iamhabban-blip/airnode-s3/images/airnode-kicad-erc-clean.png

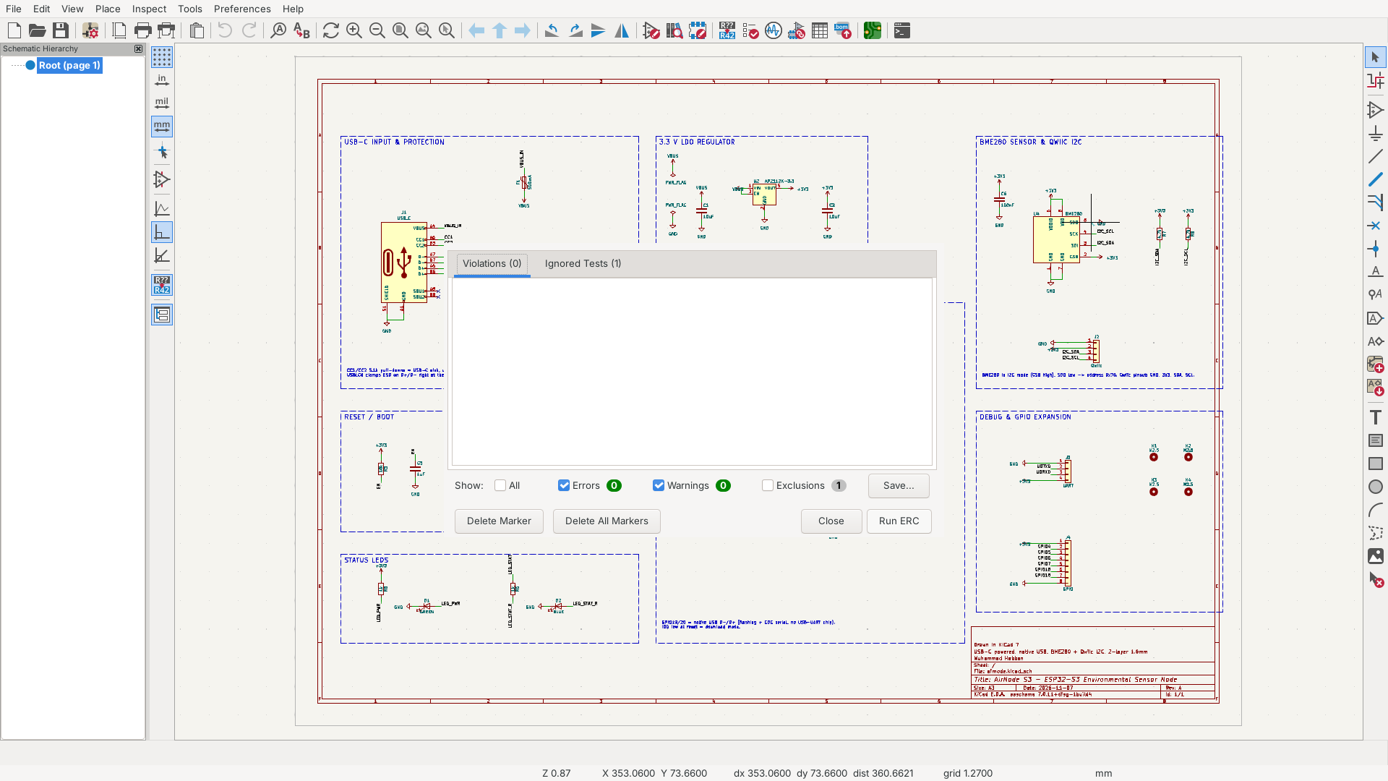
images/airnode-kicad-erc-clean.png
