iamhabban-blip/airnode-s3/images/airnode-kicad-schematic-editor.png

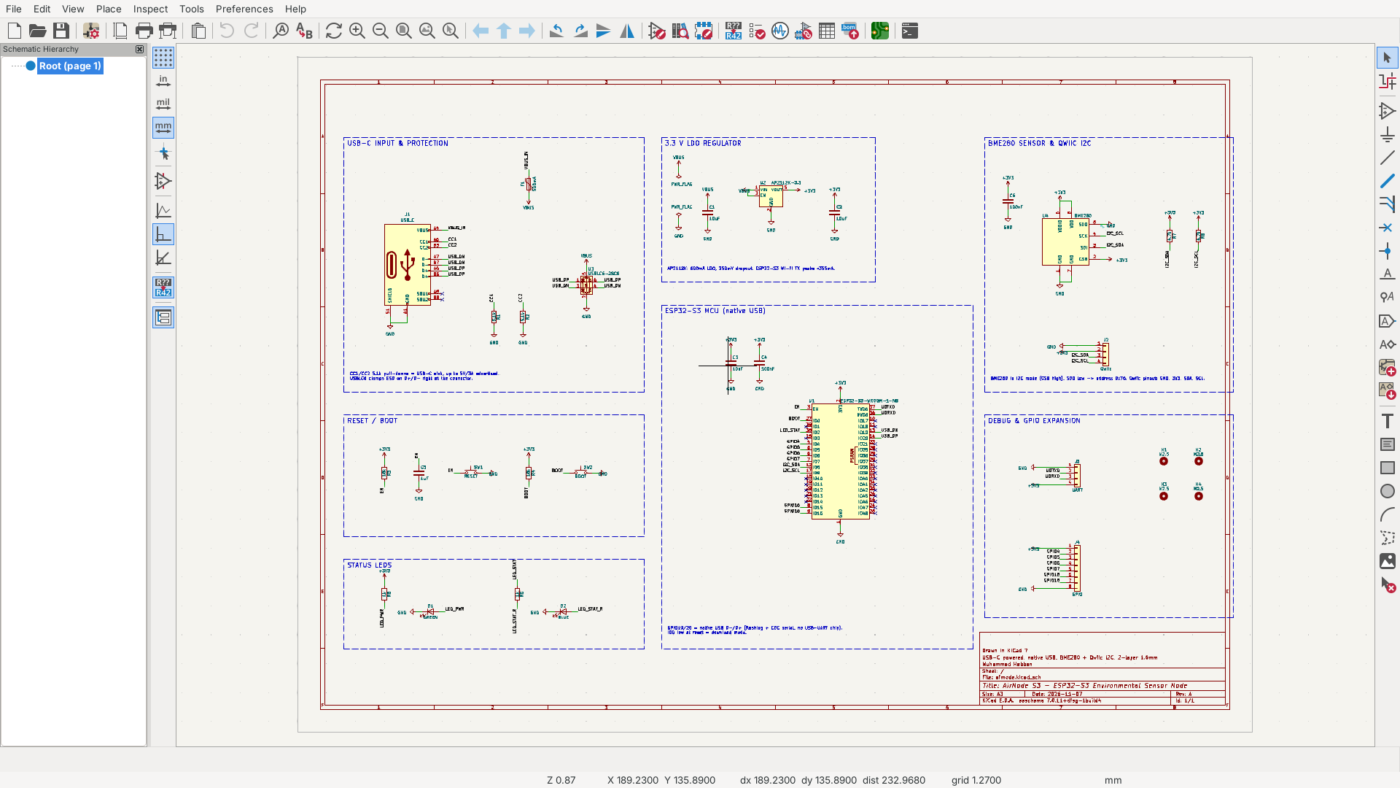
images/airnode-kicad-schematic-editor.png
