iamhabban-blip/airnode-s3/fab/airnode-bom.csv

Comment | Designator | Footprint | Manufacturer Part | Quantity | LCSC Part #
USB_C | J1 | USB_C_Receptacle_GCT_USB4105-xx-A_16P_TopMnt_Horizontal | GCT USB4105-GF-A | 1
5.1k | R1,R2 | R_0603_1608Metric |  | 2
500mA | F1 | Fuse_1206_3216Metric | Littelfuse 1206L050YR | 1
USBLC6-2SC6 | U3 | SOT-23-6 | ST USBLC6-2SC6 | 1
AP2112K-3.3 | U2 | SOT-23-5 | Diodes AP2112K-3.3TRG1 | 1
10uF | C1,C2,C3 | C_0805_2012Metric |  | 3
ESP32-S3-WROOM-1-N8 | U1 | ESP32-S3-WROOM-1 | Espressif ESP32-S3-WROOM-1-N8 | 1
100nF | C4,C6 | C_0603_1608Metric |  | 2
10k | R3,R4 | R_0603_1608Metric |  | 2
1uF | C5 | C_0603_1608Metric |  | 1
RESET | SW1 | SW_SPST_TL3342 | E-Switch TL3342F160QG | 1
BOOT | SW2 | SW_SPST_TL3342 | E-Switch TL3342F160QG | 1
1k | R5,R6 | R_0603_1608Metric |  | 2
GREEN | D1 | LED_0603_1608Metric |  | 1
BLUE | D2 | LED_0603_1608Metric |  | 1
BME280 | U4 | Bosch_LGA-8_2.5x2.5mm_P0.65mm_ClockwisePinNumbering | Bosch BME280 | 1
4.7k | R7,R8 | R_0603_1608Metric |  | 2
Qwiic | J2 | JST_SH_SM04B-SRSS-TB_1x04-1MP_P1.00mm_Horizontal | JST SM04B-SRSS-TB | 1
UART | J3 | PinHeader_1x04_P2.54mm_Vertical |  | 1
GPIO | J4 | PinHeader_1x08_P2.54mm_Vertical |  | 1
