iamhabban-blip/airnode-s3/fab/airnode.step

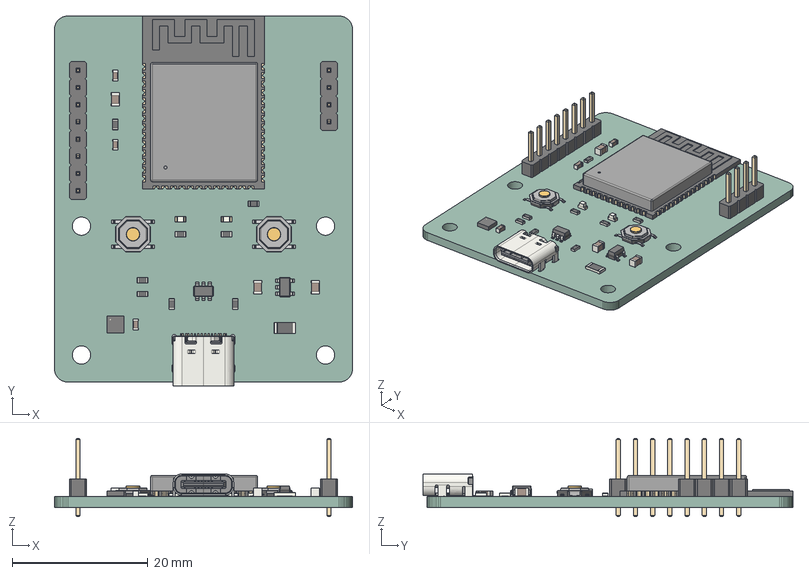
[picture p10: CAD file, 2026-11-07]
fab/airnode.step
44.0 x 54.6 x 11.5 mm
R_0603_1608Metric x 8
C_0805_2012Metric x 3
Fuse_1206_3216Metric
PinHeader_1x04_P254mm_Vertical
SW_SPST_TL3342 x 2
LED_0603_1608Metric x 2
USB_C_Receptacle_16P_TopMnt_Horizontal_GCT_USB4105-xx-A
SOT_23_6
PinHeader_1x08_P254mm_Vertical
C_0603_1608Metric x 3
Bosch_LGA_8_25x25mm_P065mm_ClockwisePinNumbering
SOT_23_5
ESP32-S3-WROOM-1
airnode PCB
