iamhabban-blip/airnode-s3/docs/airnode-assembly-top.pdf

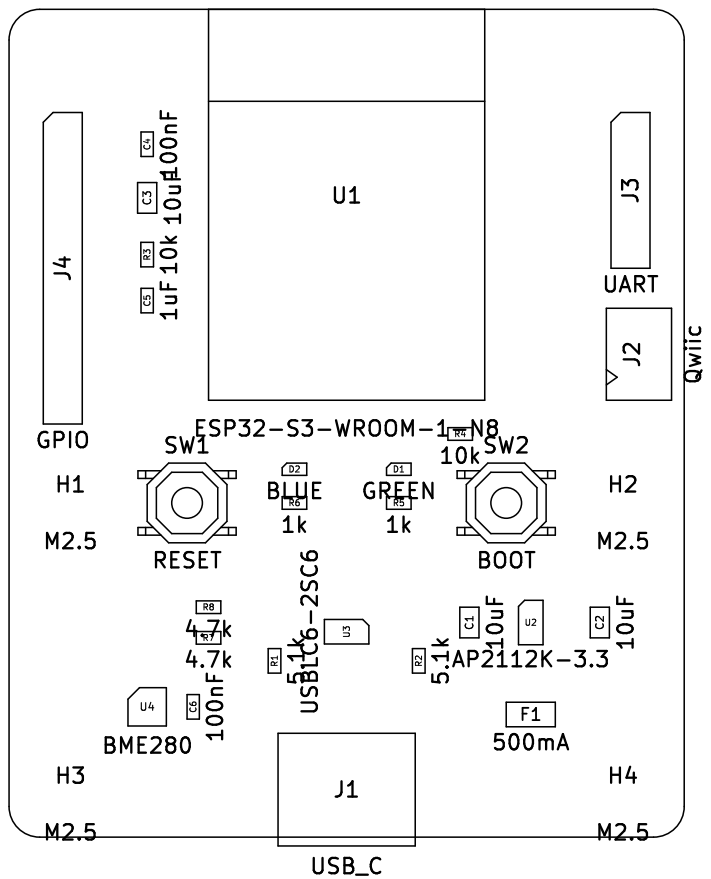
[picture p11: page 1]
