iamhabban-blip/airnode-s3/docs/airnode-schematic.pdf

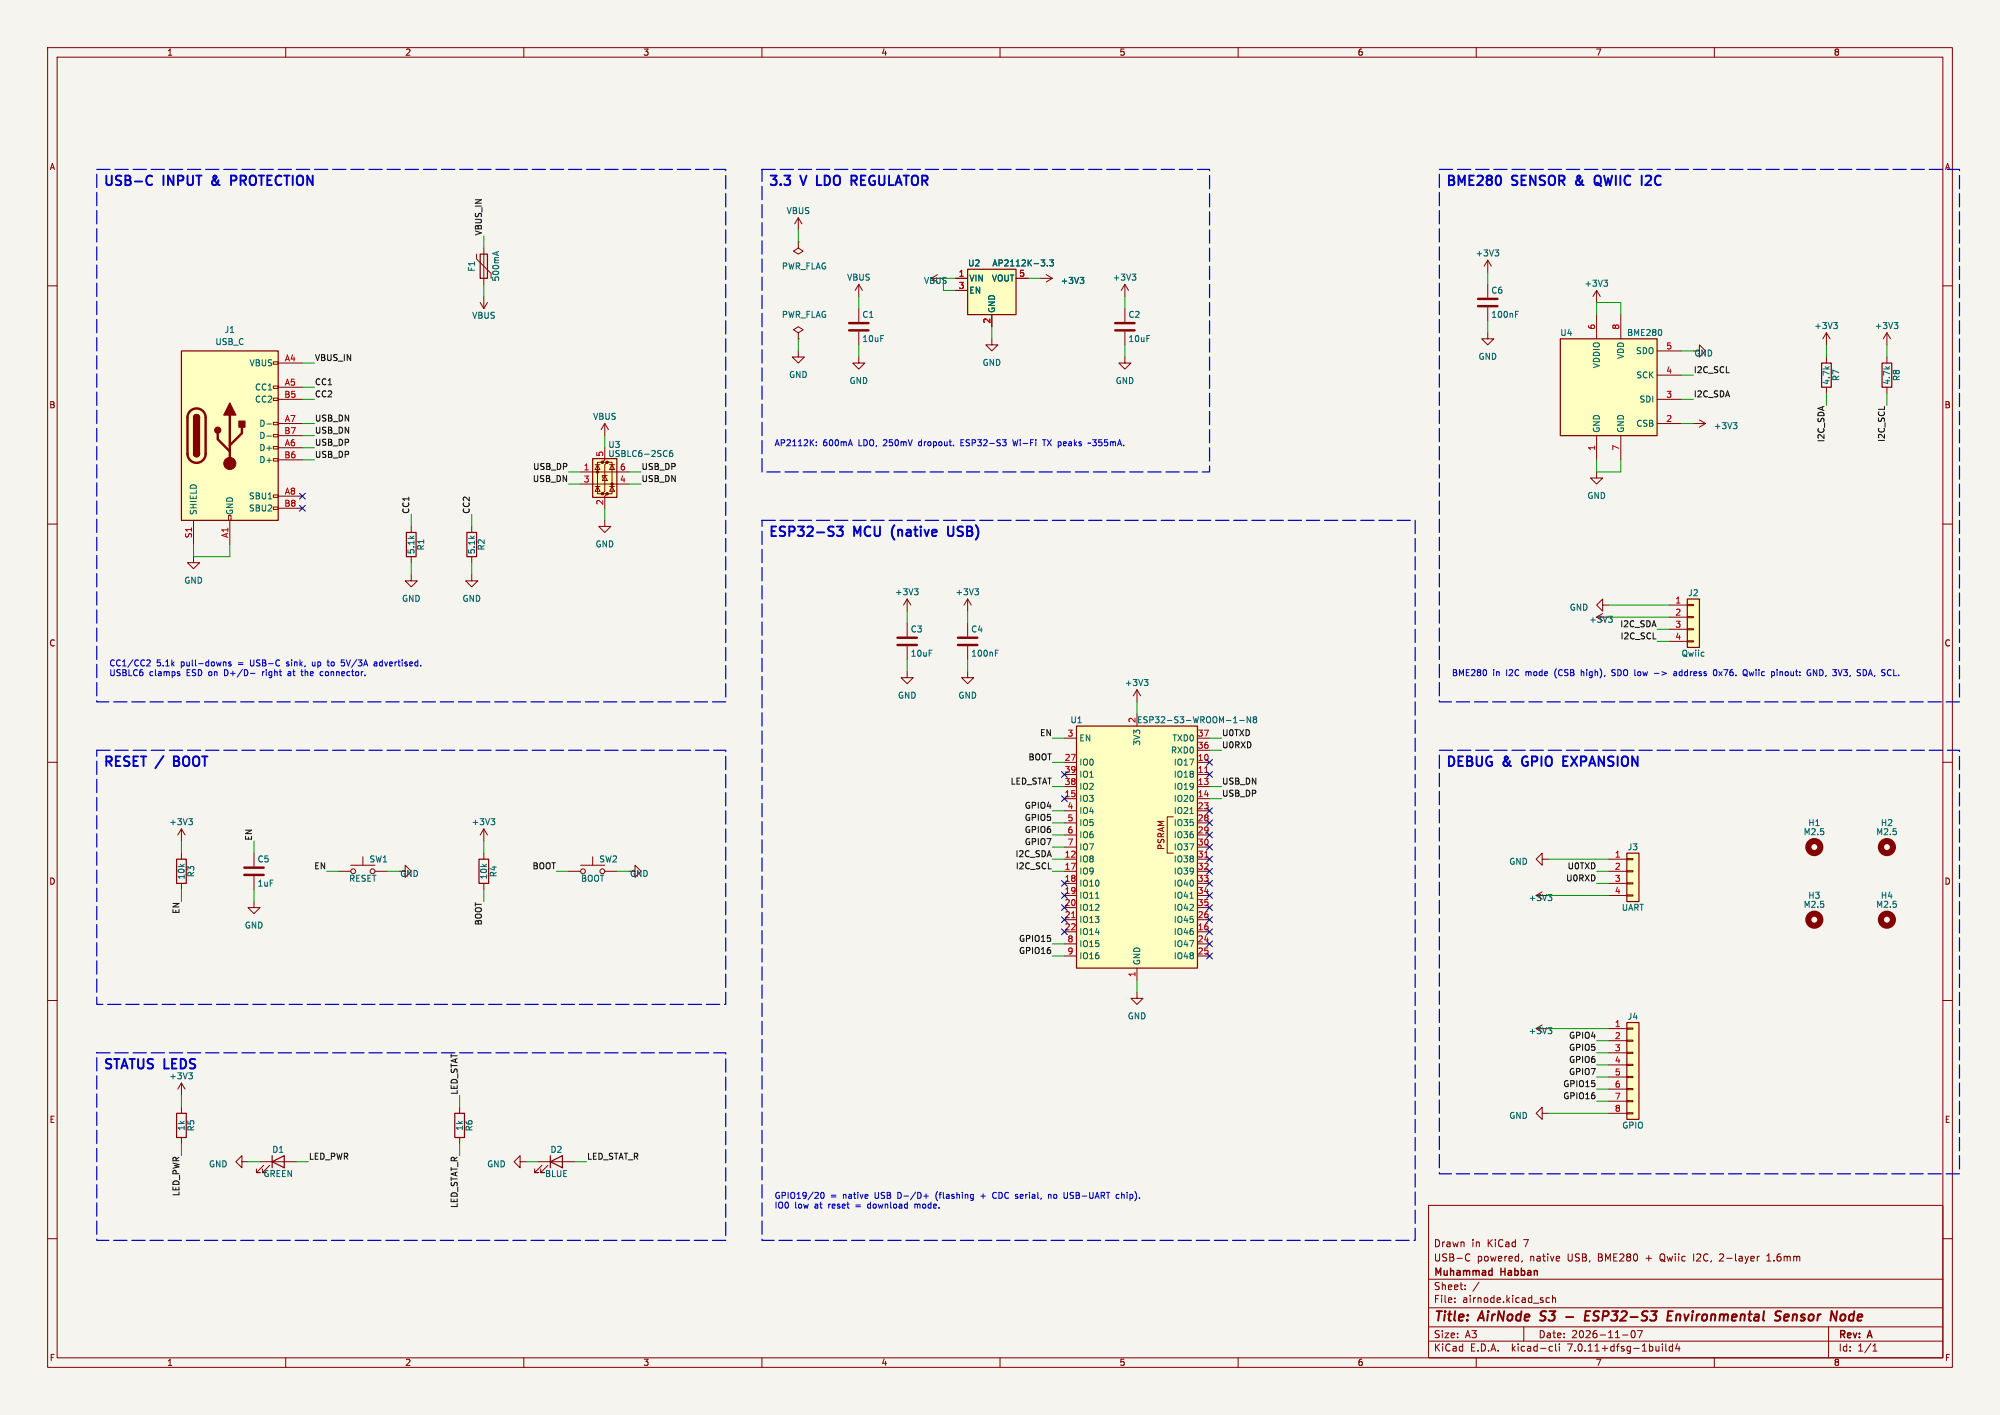
[picture p12: page 1]

1 CSB 2 SDI 3 SCK 4 SDO 5 VDDIO
