iamhabban-blip/airnode-s3/docs/airnode-layout.pdf

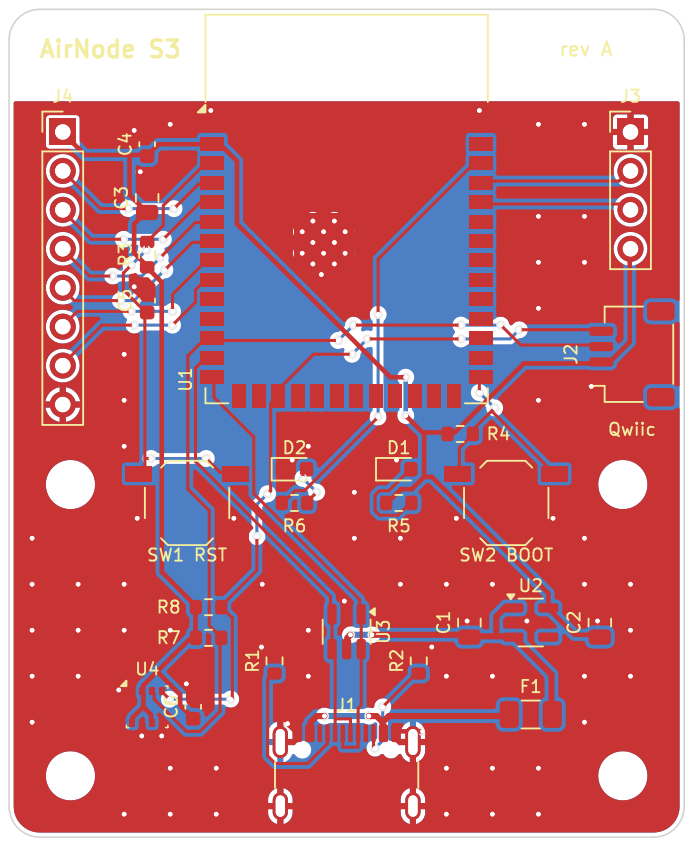
[picture p13: page 1]
