iamhabban-blip/airnode-s3/airnode.kicad_pcb

## KiCad design airnode.kicad_pcb (2026-11-07)

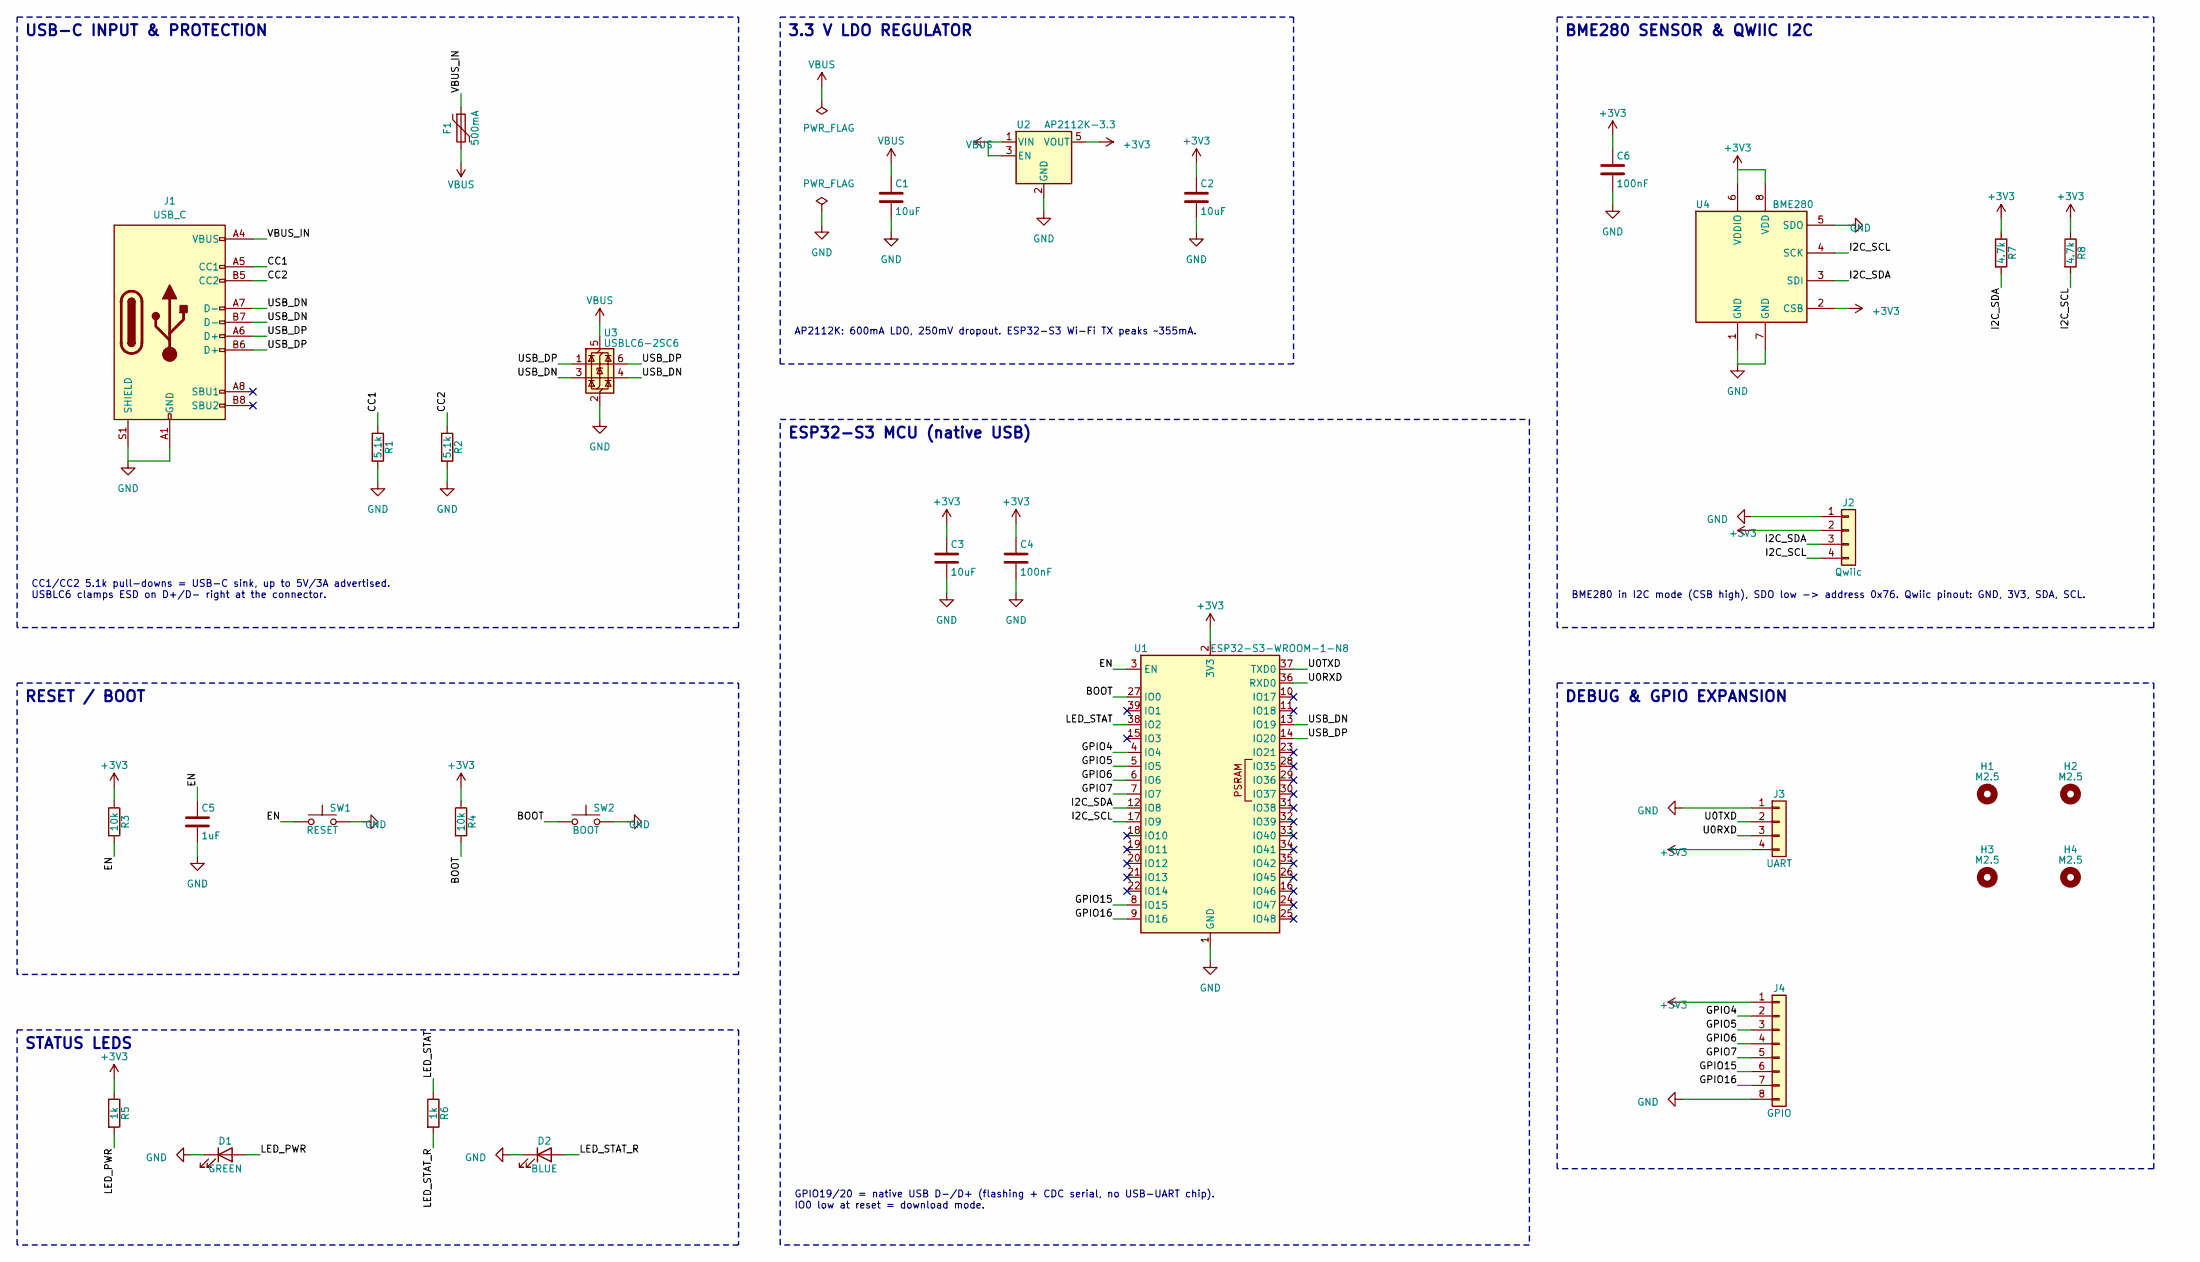
[picture p14: schematic airnode.kicad_sch, AirNode S3 - ESP32-S3 Environmental Sensor Node]

Parts:
C1, C2, C3: 10uF; C_0805_2012Metric
C4, C6: 100nF; C_0603_1608Metric
C5: 1uF; C_0603_1608Metric
D1: GREEN; LED_0603_1608Metric
D2: BLUE; LED_0603_1608Metric
F1: 500mA; Fuse_1206_3216Metric; MPN Littelfuse 1206L050YR
H1, H2, H3, H4: M2.5; MountingHole_2.7mm_M2.5
J1: USB_C; USB_C_Receptacle_GCT_USB4105-xx-A_16P_TopMnt_Horizontal; MPN GCT USB4105-GF-A
J2: Qwiic; JST_SH_SM04B-SRSS-TB_1x04-1MP_P1.00mm_Horizontal; MPN JST SM04B-SRSS-TB
J3: UART; PinHeader_1x04_P2.54mm_Vertical
J4: GPIO; PinHeader_1x08_P2.54mm_Vertical
R1, R2: 5.1k; R_0603_1608Metric
R3, R4: 10k; R_0603_1608Metric
R5, R6: 1k; R_0603_1608Metric
R7, R8: 4.7k; R_0603_1608Metric
SW1: RESET; SW_SPST_TL3342; MPN E-Switch TL3342F160QG
SW2: BOOT; SW_SPST_TL3342; MPN E-Switch TL3342F160QG
U1: ESP32-S3-WROOM-1-N8; ESP32-S3-WROOM-1; MPN Espressif ESP32-S3-WROOM-1-N8
U2: AP2112K-3.3; SOT-23-5; MPN Diodes AP2112K-3.3TRG1
U3: USBLC6-2SC6; SOT-23-6; MPN ST USBLC6-2SC6
U4: BME280; Bosch_LGA-8_2.5x2.5mm_P0.65mm_ClockwisePinNumbering; MPN Bosch BME280

Connections:
+3V3: C2.1, C3.1, C4.1, C6.1, J2.2, J3.4, J4.1, R3.1, R4.1, R5.1, R7.1, R8.1, U1.2 (3V3), U2.5 (VOUT), U4.2 (CSB), U4.6 (VDDIO), U4.8 (VDD)
BOOT: R4.2, SW2.1, U1.27 (IO0)
CC1: J1.A5 (CC1), R1.1
CC2: J1.B5 (CC2), R2.1
EN: C5.1, R3.2, SW1.1, U1.3 (EN)
GND: C1.2, C2.2, C3.2, C4.2, C5.2, C6.2, D1.1 (K), D2.1 (K), J1.A1 (GND), J1.A12 (GND), J1.B1 (GND), J1.B12 (GND), J1.S1 (SHIELD), J2.1, J3.1, J4.8, R1.2, R2.2, SW1.2, SW2.2, U1.1 (GND), U1.40 (GND), U1.41 (GND), U2.2 (GND), U3.2 (GND), U4.1 (GND), U4.5 (SDO), U4.7 (GND)
GPIO4: J4.2, U1.4 (IO4)
GPIO5: J4.3, U1.5 (IO5)
GPIO6: J4.4, U1.6 (IO6)
GPIO7: J4.5, U1.7 (IO7)
GPIO15: J4.6, U1.8 (IO15)
GPIO16: J4.7, U1.9 (IO16)
I2C_SCL: J2.4, R8.2, U1.17 (IO9), U4.4 (SCK)
I2C_SDA: J2.3, R7.2, U1.12 (IO8), U4.3 (SDI)
LED_PWR: D1.2 (A), R5.2
LED_STAT: R6.1, U1.38 (IO2)
LED_STAT_R: D2.2 (A), R6.2
U0RXD: J3.3, U1.36 (RXD0)
U0TXD: J3.2, U1.37 (TXD0)
USB_DN: J1.A7 (D-), J1.B7 (D-), U1.13 (IO19), U3.3 (I/O2), U3.4 (I/O2)
USB_DP: J1.A6 (D+), J1.B6 (D+), U1.14 (IO20), U3.1 (I/O1), U3.6 (I/O1)
VBUS: C1.1, F1.2, U2.1 (VIN), U2.3 (EN), U3.5 (VBUS)
VBUS_IN: F1.1, J1.A4 (VBUS), J1.A9 (VBUS), J1.B4 (VBUS), J1.B9 (VBUS)

Notes on the sheet:
ESP32-S3 MCU (native USB)
BME280 in I2C mode (CSB high), SDO low -> address 0x76. Qwiic pinout: GND, 3V3, SDA, SCL.
GPIO19/20 = native USB D-/D+ (flashing + CDC serial, no USB-UART chip). IO0 low at reset = download mode.
STATUS LEDS
CC1/CC2 5.1k pull-downs = USB-C sink, up to 5V/3A advertised. USBLC6 clamps ESD on D+/D- right at the connector.
3.3 V LDO REGULATOR
AP2112K: 600mA LDO, 250mV dropout. ESP32-S3 Wi-Fi TX peaks ~355mA.
RESET / BOOT
DEBUG & GPIO EXPANSION
BME280 SENSOR & QWIIC I2C
USB-C INPUT & PROTECTION

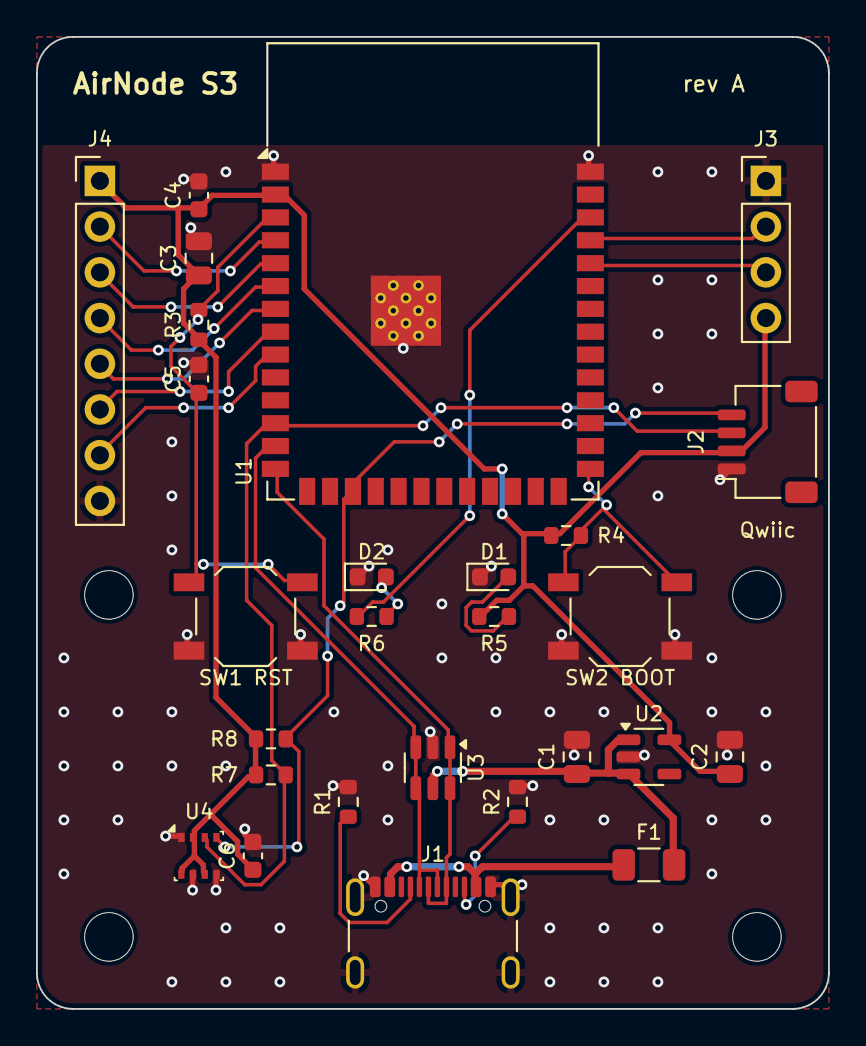
[picture p15: board airnode.kicad_pcb from above]

Board: 2 copper layers, 44.0 x 54.0 mm, 31 parts (0 on the bottom side), 23 nets.
