iamhabban-blip/airnode-s3/build-scripts/sexp.py

"""Minimal S-expression reader/writer for KiCad files."""
import re

_tok = re.compile(r'\s*(\(|\)|"(?:\\.|[^"\\])*"|[^\s()]+)')


class Sym(str):
    """Unquoted atom."""


def parse(text):
    pos, stack, cur = 0, [], []
    n = len(text)
    while pos < n:
        m = _tok.match(text, pos)
        if not m:
            break
        t = m.group(1)
        pos = m.end()
        if t == '(':
            stack.append(cur)
            cur = []
        elif t == ')':
            done = cur
            cur = stack.pop()
            cur.append(done)
        elif t.startswith('"'):
            cur.append(t[1:-1].replace('\\"', '"').replace('\\\\', '\\'))
        else:
            cur.append(Sym(t))
    return cur[0] if len(cur) == 1 else cur


def dump(e, indent=0):
    if isinstance(e, list):
        if not e:
            return '()'
        simple = all(not isinstance(x, list) for x in e)
        if simple:
            return '(' + ' '.join(dump(x) for x in e) + ')'
        parts = []
        head = []
        for x in e:
            if not isinstance(x, list) and not parts:
                head.append(dump(x))
            else:
                parts.append(x)
        s = '(' + ' '.join(head)
        for p in parts:
            s += '\n' + '  ' * (indent + 1) + dump(p, indent + 1)
        return s + '\n' + '  ' * indent + ')'
    if isinstance(e, Sym):
        return str(e)
    if isinstance(e, bool):
        return 'yes' if e else 'no'
    if isinstance(e, (int, float)):
        return fmt(e)
    return '"' + str(e).replace('\\', '\\\\').replace('"', '\\"').replace('\n', '\\n') + '"'


def fmt(v):
    if isinstance(v, int):
        return str(v)
    s = ('%.4f' % v).rstrip('0').rstrip('.')
    return '0' if s in ('-0', '') else s


def find(e, key):
    return [x for x in e if isinstance(x, list) and x and x[0] == key]


def first(e, key):
    r = find(e, key)
    return r[0] if r else None
