iamhabban-blip/airnode-s3/(commit log)

2026-11-07 AirNode S3 rev A: ESP32-S3 environmental sensor board (KiCad 7)
    Schematic, 2-layer routed PCB, project-local libraries, Gerbers,
    BOM/CPL, STEP model, ERC/DRC reports, renders and design note.
    Claude-Session: https://claude.ai/code/session_01QHtjMYuVYSEL3W2LL1Vnaq
    [airnode-B_Cu.gbl, airnode-B_Mask.gbs, airnode-B_Paste.gbp, airnode-B_Silkscreen.gbo, airnode-Edge_Cuts.gm1, airnode-F_Cu.gtl, airnode-F_Mask.gts, airnode-F_Paste.gtp]
2026-11-07 README: add board renders, schematic, editor and ERC images
    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
